dynamicx-circuit/USB2GPIO/USB2GPIO.kicad_pcb

## KiCad design USB2GPIO.kicad_pcb (2023-05-20)

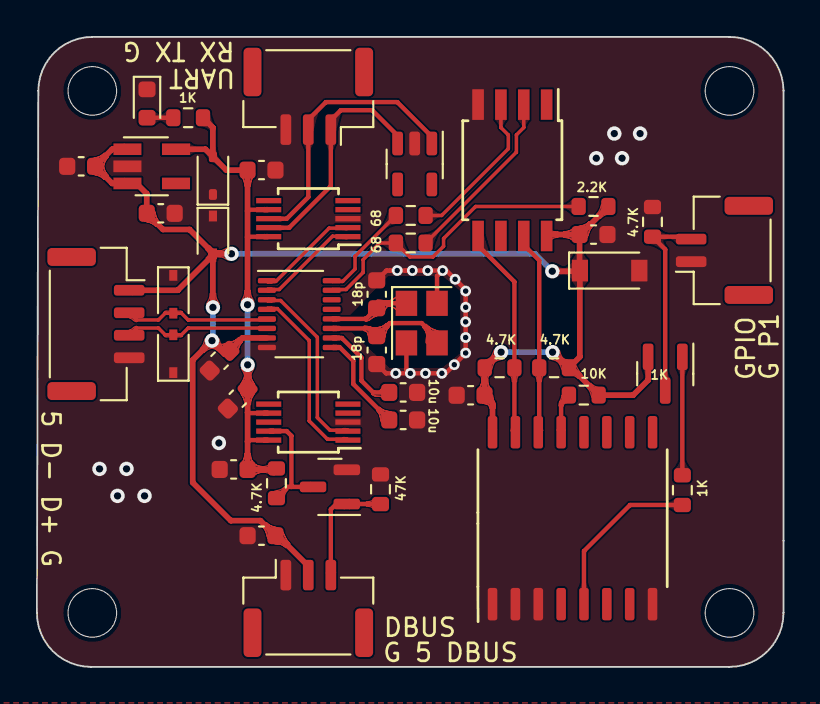
[picture p1: board USB2GPIO.kicad_pcb from above]

Board: 2 copper layers, 41.5 x 35.0 mm, 48 parts (0 on the bottom side), 28 nets.

Parts:
C5, C7, C28, C29, C30, C31, C32, C33, C38: 100n; C_0603_1608Metric
C34, C35: 10u; C_0603_1608Metric
C36, C37: 18p; C_0603_1608Metric
D1, D10, D11, D12: BV05C; D_SOD-323
D9: LED; LED_0603_1608Metric
D13: 5V1; D_SOD-123
H1, H2, H3, H4: MountingHole; MountingHole_2.7mm_M2.5
J1: Conn_01x04; JST_GH_SM04B-GHS-TB_1x04-1MP_P1.25mm_Horizontal
J7, J8: Conn_01x03; JST_GH_SM03B-GHS-TB_1x03-1MP_P1.25mm_Horizontal
J9: Conn_01x02; JST_GH_SM02B-GHS-TB_1x02-1MP_P1.25mm_Horizontal
Q1: S8050; SOT-23
Q2: Q_PNP_BEC; SOT-23
R1, R14: 1K; R_0603_1608Metric
R2, R4, R16, R17: 4.7K; R_0603_1608Metric
R3: 47K; R_0603_1608Metric
R15: 10K; R_0603_1608Metric
R18: 2.2K; R_0603_1608Metric
R19, R20: 68; R_0603_1608Metric
U1: SOT-23-5
U2, U3: CH340E; MSOP-10_3x3mm_P0.5mm
U9: ATtiny85V-10S; SOIC-8W_5.3x5.3mm_P1.27mm
U10: PCF8574T; SOIC127P1032X265-16N
U11: HX9193; SOT-23-5_HandSoldering
U12: SL2.1S; SL2.1S-SSOP-16
Y2: 12M; Crystal_SMD_3225-4Pin_3.2x2.5mm

Connections:
+5V: C28.1, C29.1, C30.1, C31.1, C32.1, C38.1, D10.2 (A2), D13.1 (A1), J1.1, J7.2, Q2.2 (E), R15.2, R16.2, R17.2, R18.2, U9.8 (VCC), U10.16 (VDD), U11.1 (VIN), U11.3 (EN), U12.7 (VDD5)
/3V3: C5.1, C7.1, C33.1, D1.2 (A2), R2.1, R14.1, U2.7 (VCC), U2.10 (V3), U3.7 (VCC), U3.10 (V3), U11.5 (VOUT)
/DBUS/D+: U3.1 (UD+), U12.4 (DP1)
/DBUS/D-: U3.2 (UD-), U12.3 (DM1)
/DBUS/DBus: J7.3, Q1.1 (B), R3.1
/GPIO/*D+: R20.1, U9.3 (XTAL2/PB4)
/GPIO/*D-: R19.1, U9.2 (XTAL1/PB3)
/GPIO/D+: R20.2, U12.16 (DP3)
/GPIO/D-: R18.1, R19.2, U12.15 (DM3)
/GPIO/P1: J9.2, Q2.3 (C), R4.2
/GPIO/SCL: R17.1, U9.7 (PB2), U10.14 (SCL)
/GPIO/SDA: R16.1, U9.5 (AREF/PB0), U10.15 (SDA)
/UART/D+: U2.1 (UD+), U12.2 (DP2)
/UART/D-: U2.2 (UD-), U12.1 (DM2)
/UART/RXD: J8.1, U1.3 (I/O2), U2.9 (RXD)
/UART/TXD: J8.2, U1.1 (I/O1), U2.8 (TXD)
/USB_HUB/D+: D12.2 (A2), J1.3, U12.6 (UDP)
/USB_HUB/D-: D11.2 (A2), J1.2, U12.5 (UDM)
/USB_HUB/XIN: C37.1, U12.12 (XIN), Y2.1
/USB_HUB/XOUT: C36.1, U12.11 (XOUT), Y2.3
GND: C5.2, C7.2, C28.2, C29.2, C30.2, C31.2, C32.2, C33.2, C34.2, C35.2, C36.2, C37.2, C38.2, D1.1 (A1), D9.1 (K), D10.1 (A1), D11.1 (A1), D12.1 (A1), D13.2 (A2), J1.4, J7.1, J8.3, J9.1, Q1.2 (E), R3.2, R4.1, U1.2 (GND), U2.3 (GND), U3.3 (GND), U9.4 (GND), U10.1 (A0), U10.2 (A1), U10.3 (A2), U10.8 (VSS), U11.2 (GND), U12.8 (VSS), Y2.2, Y2.4
unnamed: D9.2 (A), R14.2
unnamed: Q1.3 (C), R2.2, U3.9 (RXD)
unnamed: Q2.1 (B), R1.1
unnamed: R1.2, U10.5 (P1)
unnamed: R15.1, U10.13 (~INT)
unnamed: C35.1, U12.10 (VDD18)
unnamed: C34.1, U12.9 (VDD33)
