dynamicx-circuit/USB2GPIO/(commit log)

2022-08-29 Add USB2GPIO sch
    [DBUS.kicad_sch, GPIO.kicad_sch, PWR.kicad_sch, UART.kicad_sch, USB2GPIO.kicad_pcb, USB2GPIO.kicad_sch, USB_HUB.kicad_sch]
2022-09-01 PCB drawn
    [DBUS.kicad_sch, GPIO.kicad_sch, PWR.kicad_sch, UART.kicad_sch, USB2GPIO.kicad_pcb, USB2GPIO.kicad_sch, USB_HUB.kicad_sch]
2022-09-02 Change footprint of MX1.25 and change some routings and silkscreens
    [USB2GPIO.kicad_pcb]
2022-11-15 Change '5V' tag to '+5V' net
    [DBUS.kicad_sch, USB2GPIO.kicad_pcb]
2022-11-15 Change gpio-pin from P0 to P1
    [USB2GPIO.kicad_pcb, USB2GPIO.kicad_sch, USB2GPIO_BOM.csv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]
2022-12-12 Change the map and rebuild the PCB
    [DBUS.kicad_sch, GPIO.kicad_sch, PWR.kicad_sch, UART.kicad_sch, USB2GPIO.kicad_pcb, USB2GPIO.kicad_sch, USB2GPIO_BOM.csv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]
2023-01-12 Add output protect
    [USB2GPIO.kicad_pcb, USB2GPIO.kicad_sch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]
2023-03-05 A try to add pull-up resistor for gpio_out
    [GPIO.kicad_sch, USB2GPIO.kicad_pcb, USB2GPIO.kicad_sch, USB2GPIO_BOM.csv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]
2023-04-15 Change pnp to a pull-up resistance
    [USB2GPIO.kicad_pcb, USB2GPIO_BOM.csv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]
2023-04-30 Add ESD protection
    [DBUS.kicad_sch, GPIO.kicad_sch, PWR.kicad_sch, UART.kicad_sch, USB2GPIO.kicad_pcb, USB2GPIO.kicad_sch, USB_HUB.kicad_sch]
2023-05-20 Return to PNP-out
    [GPIO.kicad_sch, USB2GPIO.kicad_pcb]
